wtarreau/iot-heat/photos/06-testing.jpg

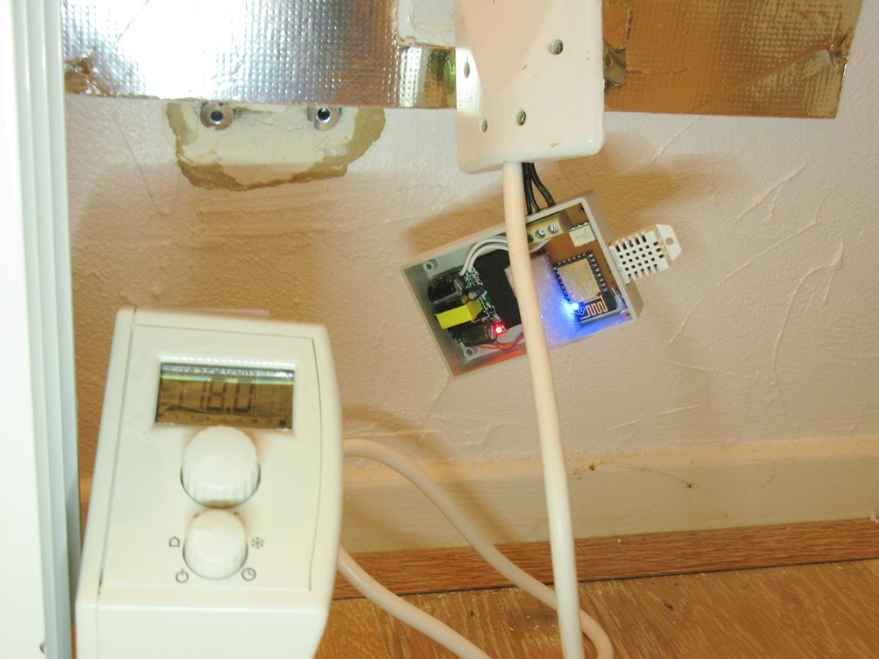
photos/06-testing.jpg
