wtarreau/iot-heat/doc/assembled.jpg

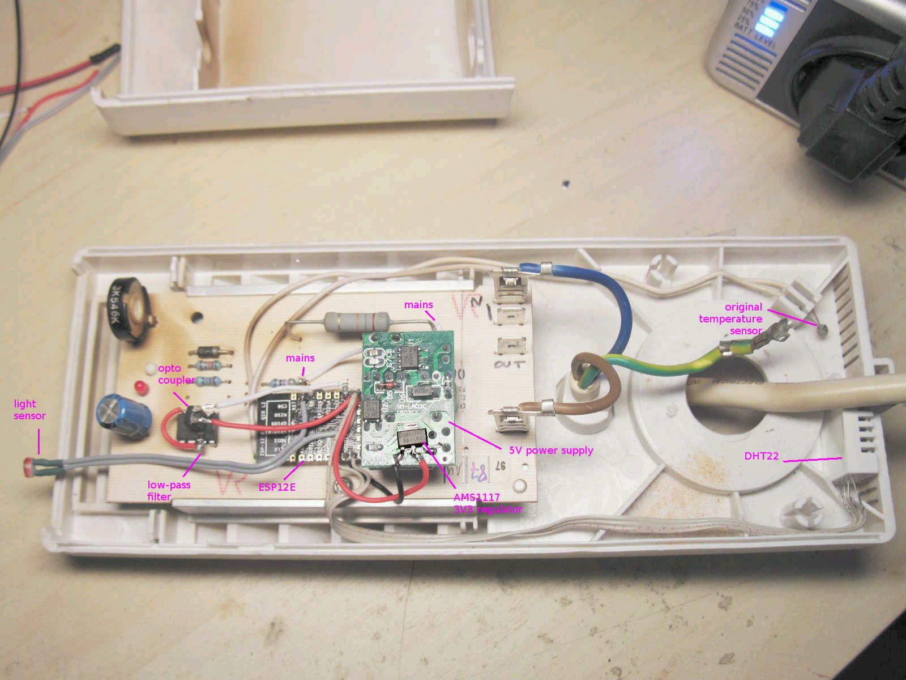
doc/assembled.jpg
