wtarreau/iot-heat/doc/archi.png

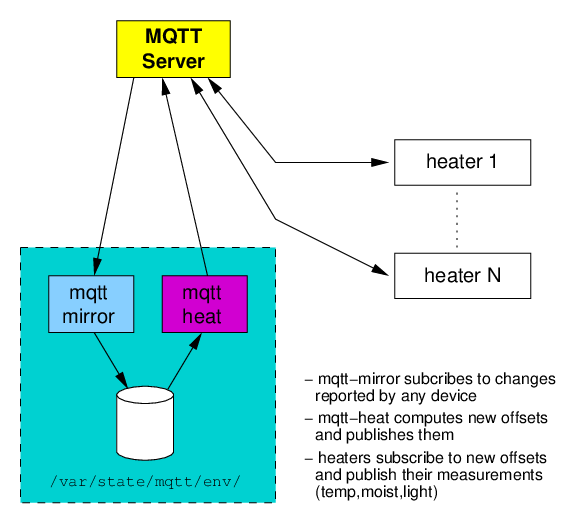
doc/archi.png
