wtarreau/iot-heat/photos/01-bottom.jpg

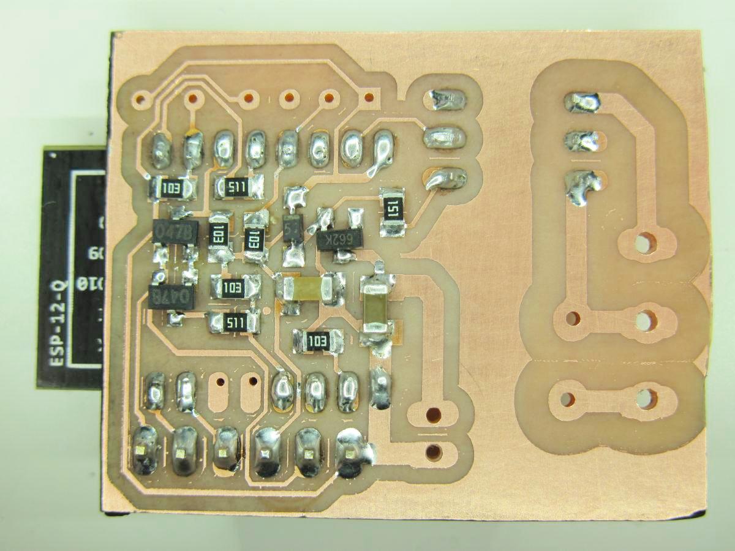
photos/01-bottom.jpg
