wtarreau/iot-heat/photos/02-top.jpg

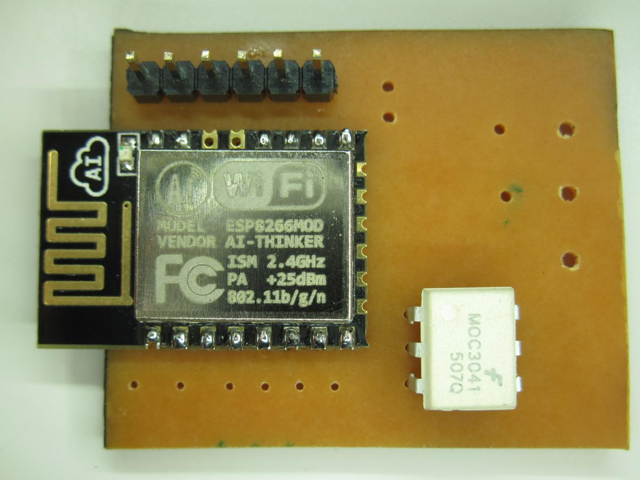
photos/02-top.jpg
