wtarreau/iot-heat/photos/03-serial.jpg

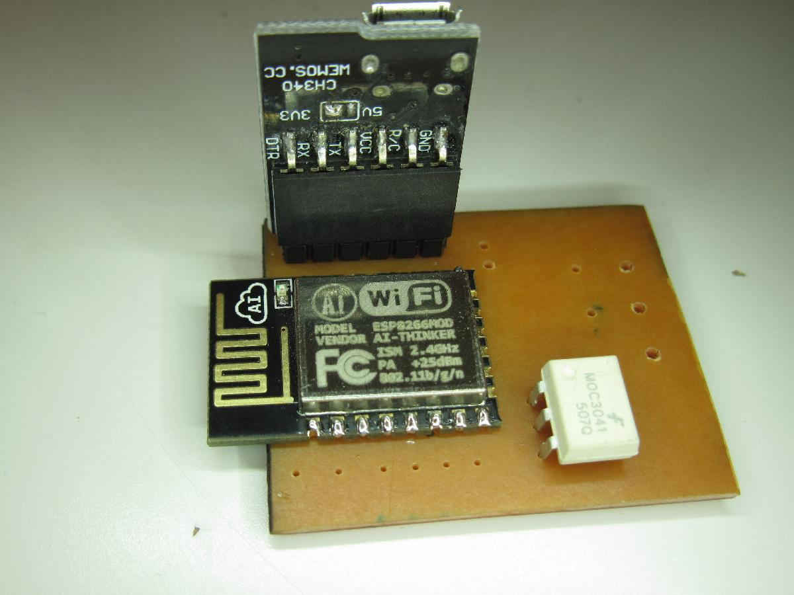
photos/03-serial.jpg
