wtarreau/iot-heat/photos/05-pinout.jpg

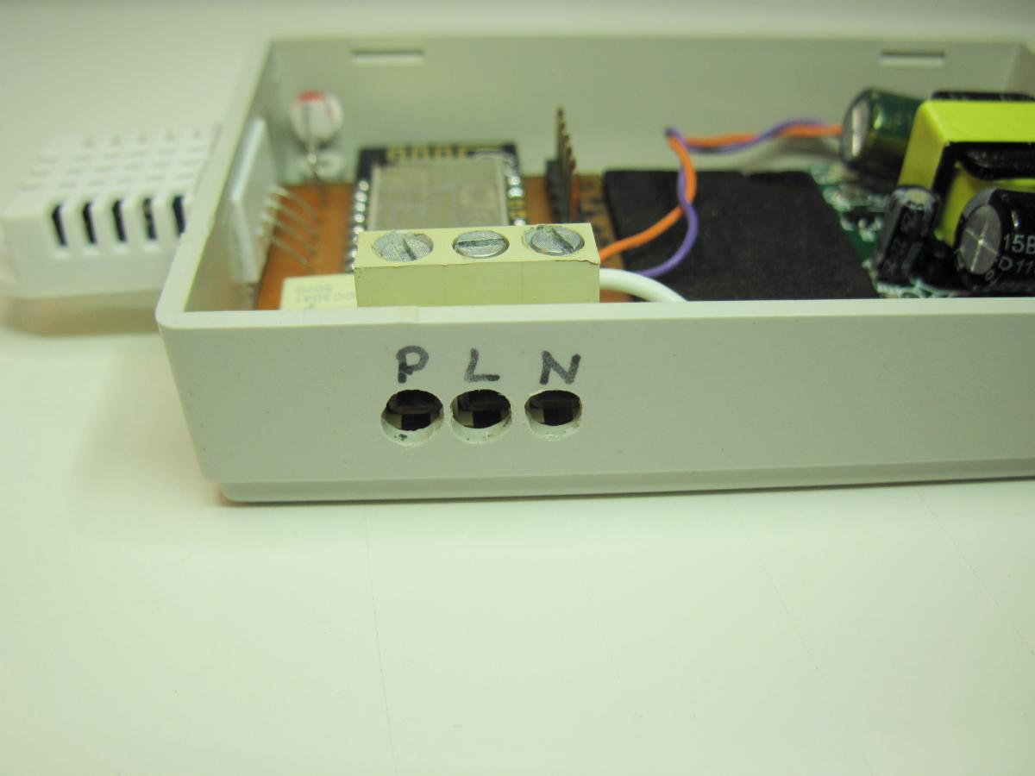
photos/05-pinout.jpg
