wtarreau/iot-heat/schematics/board-top.png

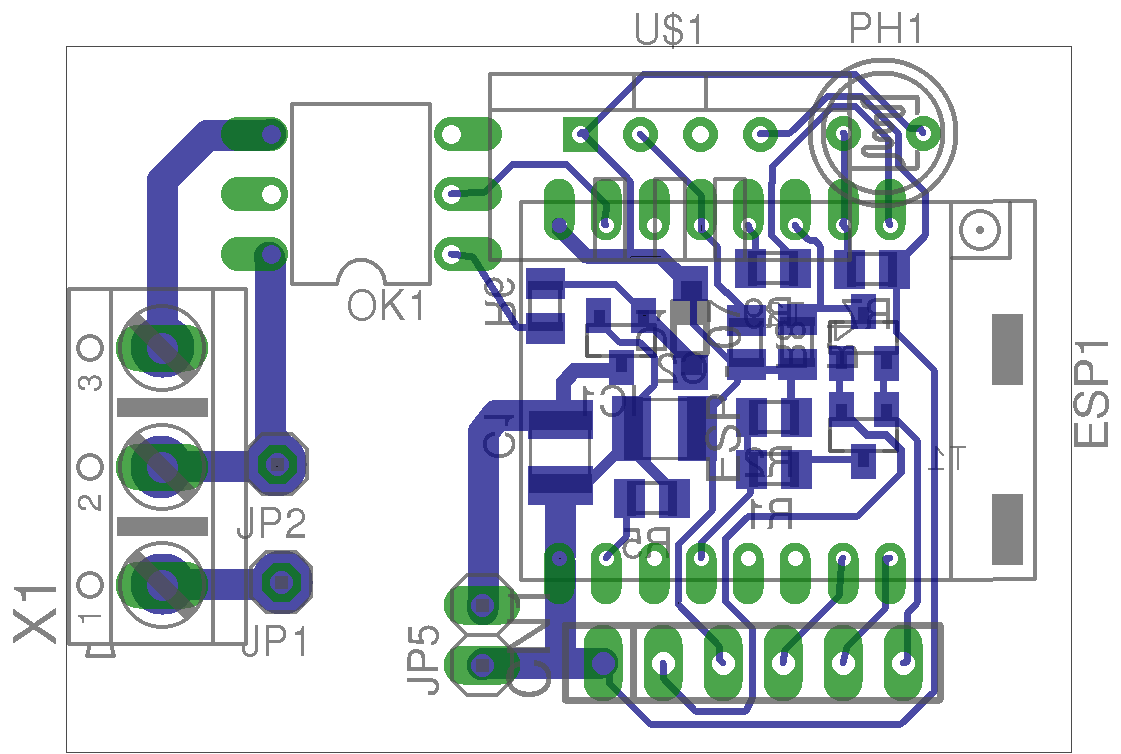
schematics/board-top.png
