wtarreau/iot-heat/schematics/schematic.png

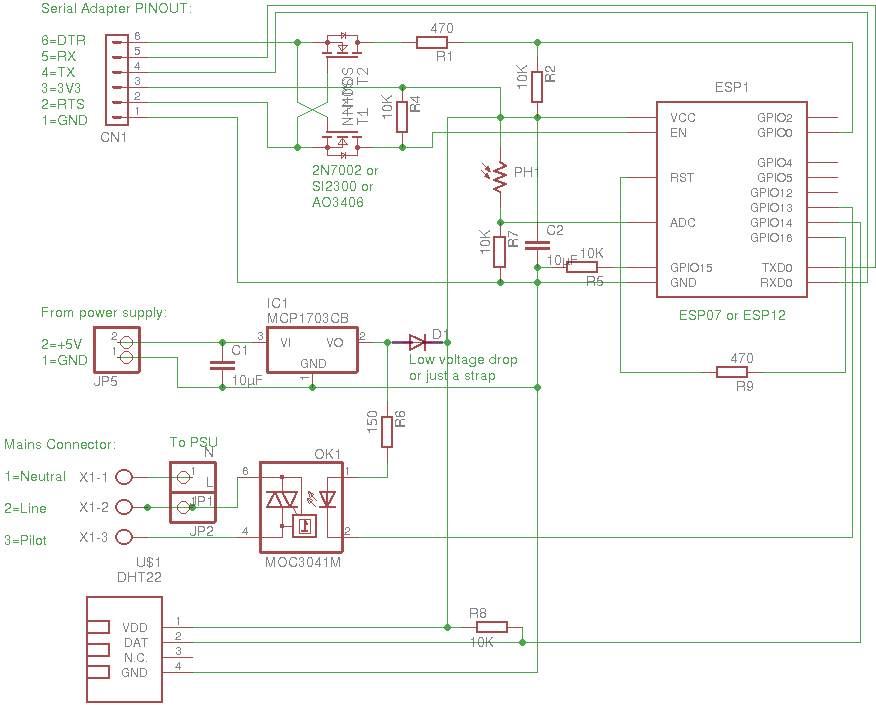
schematics/schematic.png
