wtarreau/iot-heat/schematics/pilote.brd

## EAGLE design schematics/pilote.brd (2020-02-03)

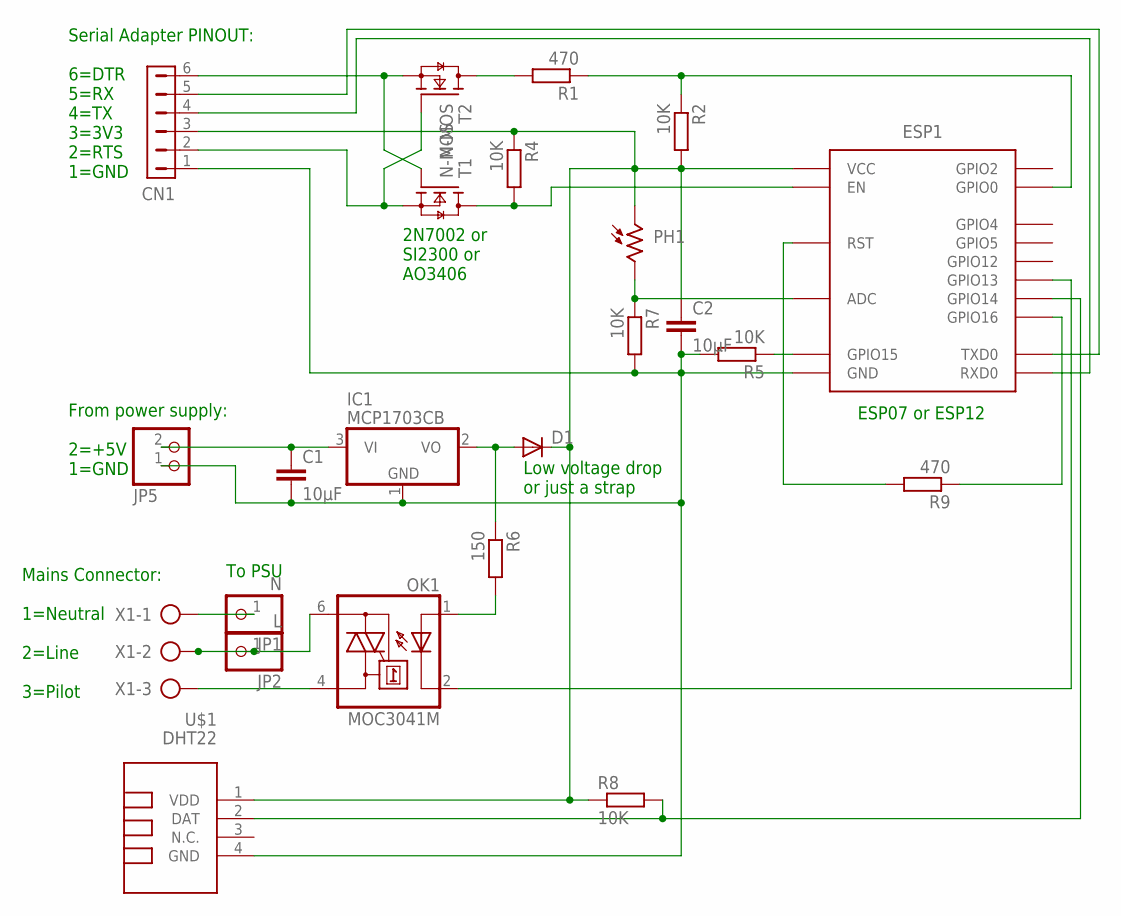
[picture p10: schematic pilote.sch]

Parts:
C1, C2: 10µF; C1210
CN1: HDR-1X6-SIP-100; SIP-100-6V
D1: DIODE-SOD123; SOD123
ESP1: ESP8266-07THT; ESP-07
IC1: MCP1703CB; SOT23
JP1: N; 1X01
JP2: L; 1X01
JP5: PINHD-1X2; 1X02
OK1: MOC3041M; DIL06
PH1: A1050_09; T0-46-A10XX
R1, R9: 470; M0805
R2, R4, R5, R7, R8: 10K; M0805
R6: 150; M0805
T1, T2: N-MOS; SOT23
U$1: DHT22; TEMP-HUM-SENSOR-DHT22
X1: AK500/3

Connections:
unnamed: ESP1.ADC, PH1.2, R7.1
unnamed: CN1.2, T1.1 (G), T2.2 (S)
unnamed: CN1.6, T1.2 (S), T2.1 (G)
unnamed: OK1.4 (A1), X1.3
unnamed: R1.2, T1.3 (D)
unnamed: ESP1.GPIO0, R1.1, R2.1
unnamed: C2.1, CN1.3, D1.C, ESP1.VCC, PH1.1, R2.2, R4.1, R8.1, U$1.1 (VDD)
unnamed: JP1.1, X1.1
unnamed: ESP1.EN, R4.2, T2.3 (D)
unnamed: ESP1.RST, R9.2
unnamed: ESP1.GPIO15, R5.1
unnamed: C1.1, IC1.3 (VI), JP5.2
unnamed: C1.2, C2.2, CN1.1, ESP1.GND, IC1.1 (GND), JP5.1, R5.2, R7.2, U$1.4 (GND)
unnamed: OK1.1 (A), R6.2
unnamed: JP2.1, OK1.6 (A2), X1.2
unnamed: CN1.4, ESP1.RX (RXD0)
unnamed: ESP1.GPIO13, OK1.2 (C)
unnamed: CN1.5, ESP1.TX (TXD0)
unnamed: ESP1.GPIO14, R8.2, U$1.2 (DAT)
unnamed: ESP1.GPIO16, R9.1
unnamed: D1.A, IC1.2 (VO), R6.1

Notes on the sheet:
Serial Adapter PINOUT: 6=DTR 5=RX 4=TX 3=3V3 2=RTS 1=GND
From power supply: 2=+5V 1=GND
Mains Connector: 1=Neutral 2=Line 3=Pilot
To PSU
Low voltage drop or just a strap
ESP07 or ESP12
2N7002 or SI2300 or AO3406

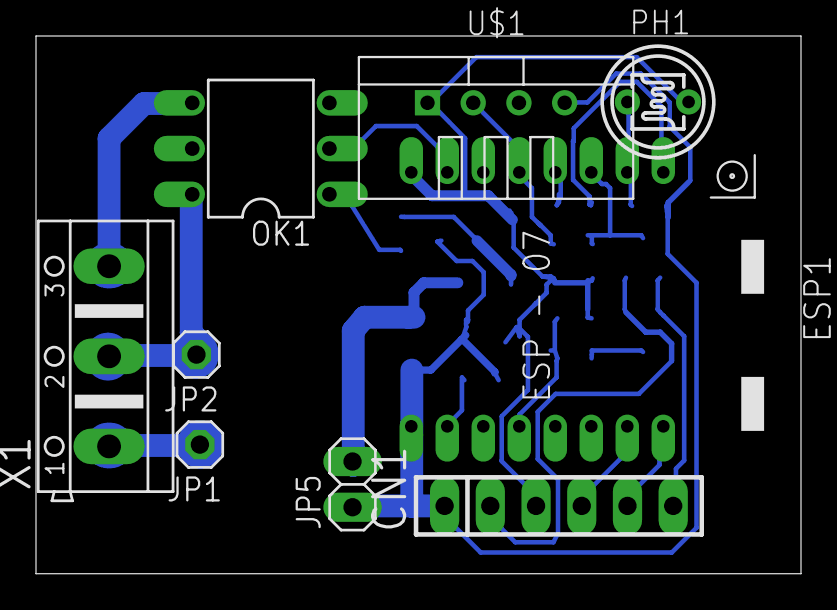
[picture p11: board pilote.brd from above]

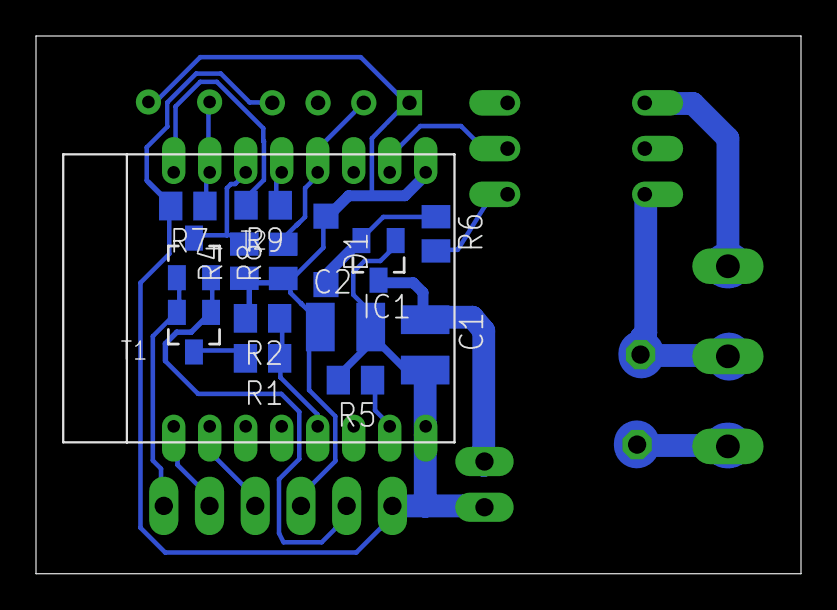
[picture p12: board pilote.brd from below]

Board: 2 copper layers, 42.5 x 29.9 mm, 23 parts (14 on the bottom side), 21 nets.
