wtarreau/iot-heat/photos/04-assembled.jpg

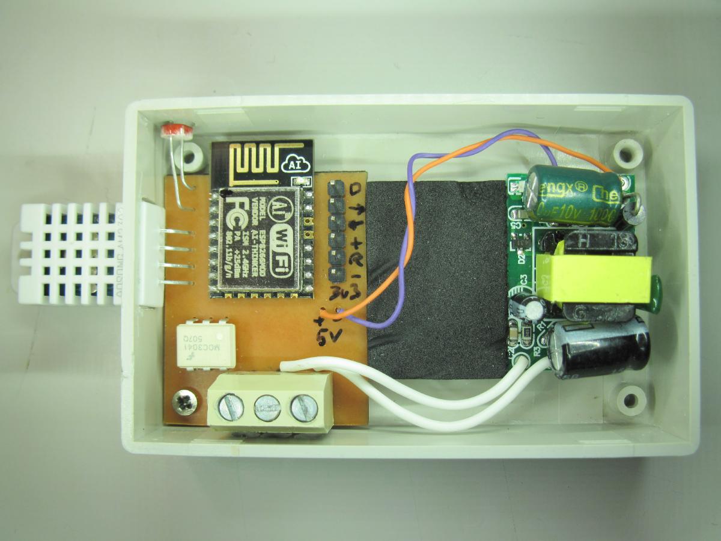
photos/04-assembled.jpg
