wtarreau/iot-heat/conf/heat-cfg-pilot.lua

-- config for pilot wire: ECO=full output, others default.
heat_pwm_ECO=0
heat_pwm_NORMAL=1023
heat_pwm_STRONG=1023
heat_pwm_FAST=1023

heat_p_NIGHT_LIT="NORMAL"
heat_p_NIGHT_DRK="ECO"
heat_p_MORNING_LIT="NORMAL"
heat_p_MORNING_DRK="NORMAL"
heat_p_ATHOME_LIT="NORMAL"
heat_p_ATHOME_DRK="NORMAL"
heat_p_AWAY_LIT="ECO"
heat_p_AWAY_DRK="ECO"
heat_p_EVENING_LIT="NORMAL"
heat_p_EVENING_DRK="ECO"
heat_p_TOBED_LIT="NORMAL"
heat_p_TOBED_DRK="ECO"
