wtarreau/iot-heat/(commit log)

2019-01-13 code: heat: add a new application to manage heating devices
    This application connects over MQTT and publishes a few values, for
    now only the measurement of the light sensor to detect people's presence.
    It also subscribes to some topics to get PWM values to be used during day
    and night, as well as an optional change in the limit between day and night.
    For now it checks these elements every second as it's easier for debugging,
    but the frequency could be arranged and a cache could be used for unchanged
    values.
    The PWM output is not affected yet, only the light is read. No temperature
    is read either.
    All variables and MQTT information are detailed in the doc.
2019-01-13 code: heat: implement a cache of MQTT publications
    The principle is not to resubmit values which have not changed, as is
    the case for most constants and thresholds.
2019-01-13 code: heat: implement the PWM setting on subscription
    Now we also set the heat_pwm_day and heat_pwm_night variables when
    receiving them, and we use them to dynamically update the PWM output
    on each timer call.
2019-01-13 code: heat: implement automatic reconnection after an error
    The MQTT connect() immediately fails when started before the network
    is ready, and doesn't retry. For this reason we implement automatic
    reconnection when trying to send a message in the update timer. We
    now maintain 3 states : disconnected(0), connecting(1), connected(2).
    Any publication will automatically lead to an attempt to reconnect.
    [heat.lua]
2019-01-13 code: heat: make the light reading function update the global value
    Better have sensors automatically update the current value, as
    we'll have to take into account the operation success for some
    of them.
2019-01-13 code: heat: now also read the temperature and humidity in the loop
    For this we read the DHT22 sensor and update the respective global
    variables (heat_temp_cur and heat_humi_cur).
2019-01-13 code: heat: publish temperature and humidity readings
    We implement the read cache and publish the changes over MQTT
    as humi_cur (percent between 0.0 and 100.0) and temp_cur (float
    as well, in celsius).
2019-01-13 code: heat: change default light threshold
    On the new version of the design, the light sensor spans a much wider
    range and detects light through the plastic. Lower the threshold to
    100 to detect between night and day.
2019-01-13 code: heat: remove the code used to manipulate gpio for adc
    The prototype used to employ two analog devices multiplexed using GPIO.
    These ones don't exist anymore, remove this code.
2019-01-13 doc: heat: add new states do describe periods of the day
    We now have 8 states :
    NIGHT, WAKEUP, MORNING, ATHOME,
    AWAY, BACK, EVENING, TOBED
    For each of them a profile will be applied for light and darkness.
    Each of these profiles will correspond to a heating offset.
2019-01-13 code: add a new script "mqtt-heating" for the controller
    This one sets some "environment" variables, the most important one
    being "state" to indicate what state the house is in among 8 possible.
    It collects the light from a few online nodes and has some preset
    time boundaries. It's very experimental for now.
2019-01-13 code: heat: retrieve the current state from the environment
    The central controller is supposed to be running mqtt-heating to update
    the environment based on the time of day and a collection of lights from
    various nodes. For now it's not used.
2019-01-13 code: heat: add support for a config file to set the profile
    The new file cfg/heat-cfg.lua will be sourced if it exists. It will
    be used to set the various PWM levels for all 4 profiles, and the
    profiles to be used for each combination of state,light.
2019-01-13 code: heat-cfg: provide example heat config file for a living room
    This is for a living room, in short, STRONG heating in the morning,
    ECO mode when away, NORMAL heating when there's light, ECO for the
    rest.
    [heat-cfg.lua]
2019-01-13 code: heat: now take the heating profile into account for the PWM
    The moment of the day is retrieved from MQTT and combined with the
    light detection to give the current heating profile. This heating
    profile is then converted to PWM.
    The FAST mode is not implemented for now.
2019-01-13 code: heat: support fast heating when leaving ECO mode
    When leaving ECO mode, we switch to FAST state for at most as long as
    we were in ECO mode, limited to 1000 seconds. One of the limits is that
    if the heater is turned on cold without going to ECO mode, we don't
    know how to turn it to FAST mode. If we did it it would cause the heater
    to be set to full throttle upon each turn on, which is not desirable.
2019-01-13 code: heat: increase the temperature offset by 10% when humidity > 70%
    This is in order to improve comfort. It's done on a per-heater basis.
2019-01-13 code: mqtt-heating: add a transition from evening to morning
    This is for when "tobed" was not performed whatever the reason.
    Also some time checks were improved because some 'ge' and 'lt'
    are insufficient given that they're here to imply "after" but
    don't take into account to wrapping of time. There are still a
    lot to fix.
2019-01-13 MINOR: heat: support touching /tmp/returning to set BACK
    It should be changed to allow to force any state.
2019-01-13 MINOR: heat: allow more transitions to BACK
    for example it was not possible to enter it at night or during the day.
2019-01-13 code: mqtt-heating: earlier wake-up
    Let's use 3h30 pre-heat and 5h30 leave time.
2019-01-13 code: add board.lua
    This sets the I/O pins used in the project, though most are hard-coded,
    but at least the recovery button allows to get back to a shell in case
    of problem.
    [board.lua]
2019-01-13 conf: add sample configurations
    These ones show how to quickly configure the mqtt server and the network.
2019-01-13 doc: add a photo of the final assembly
    This helps identifying how to place most components.
2019-01-13 doc: add a diagram explaining the architecture
    This shows how the heaters and central controller communicate via the
    MQTT server.
2019-01-22 code: mqtt-heating: support sending an e-mail alert
    The code may stop working because of network errors for example. In
    this case, provide the option to send an e-mail alert before quitting.
2020-02-03 code: make the DHT pin configurable
    It's now brd_dht and not the hard-coded value "4" for GPIO2.
2020-02-03 code: make the PWM pin configurable
    No need for this one to be hard-coded either.
2020-02-03 conf: move board.lua from code to conf
    It's mostly a matter of board configuration and variations may occur
    depending on the module in use, so make this pure config and not code.
2020-02-03 conf: move heat-cfg.lua to the conf directory
    This one may also change based on board variations (e.g. PWM values) so
    it definitely is config more than code.
2020-02-03 code: make the onboard led blink to reflect activity and mode
    During each call to the timer, we'll blink the onboard led if it is
    defined (brd_led, brd_led_inv). In ECO mode, the led is off by default
    and flashes on. In other modes, the led is on by default and flashes
    off. Note that the onboard LED on ESP12E and newer is connected to
    GPIO2 (D4) which is also the pin that was used to connect the DHT
    module on some boards.
2020-02-03 conf: add a variant for Pilot Wire
    This variant connects a MOC3041 triac to the PWM output which is then
    used in full-on, full-off mode. It would be interesting to see if by
    modulating it at 50 Hz and using a half-wave ratio it's possible to
    switch to the -1 or -2 degrees that some devices support, or if this
    requires phase synchronization.
2020-02-03 code: change the PWM speed without a setup phase
    Doing a setup()+start() cycle every second causes short pulses on output
    that are noticeable, especially when no signal should be emitted. Instead
    let's use a setup() phase and a write() phase which remains synchronous.
    [heat.lua]
2020-02-03 code: remove unused heat_pwm_day and heat_pwm_night variables
    These ones were learned over MQTT but never used. Let's remove them.
2020-02-03 schematic: add the schematic, board and corresponding images
    This will ease duplicating the device. The circuit is purpusely single
    sided, with all the generic stuff under the ESP and the project-specific
    one around, so that adapting it to any other use case should be easy.
    Particular care was given to make the default circuit entirely fit under
    the ESP so that a programming board could be made to use in sandwich
    between the ESP and any other board, with only the programming connector
    being available.
    The programming is made using the GPIO and EN pin so that GPIO16 can
    still be used with RESET to keep the watchdog operational.
    [pilote.brd, pilote.sch]
2020-02-03 photos: add photos of various stages of the realization
    These may also be useful to try to diagnose malfunction.
2020-04-08 code: add node 8403863 to meaningful light sensors
    This node will report a valid light state now.
