wtarreau/iot-heat/(notices)

Notices in the files:
parts and their libraries:
con-hdrs40: Copyright (C) 2004, Bob Starr (bobstarr@mindspring.com)
diy-modules: Released under the Creative Commons Attribution 4.0 International License: http://creativecommons.org/licenses/by/4.0
